MBifolco/jarvis-pcb/jarvis/jarvis.kicad_pcb

## KiCad design jarvis/jarvis.kicad_pcb (2025-08-11)

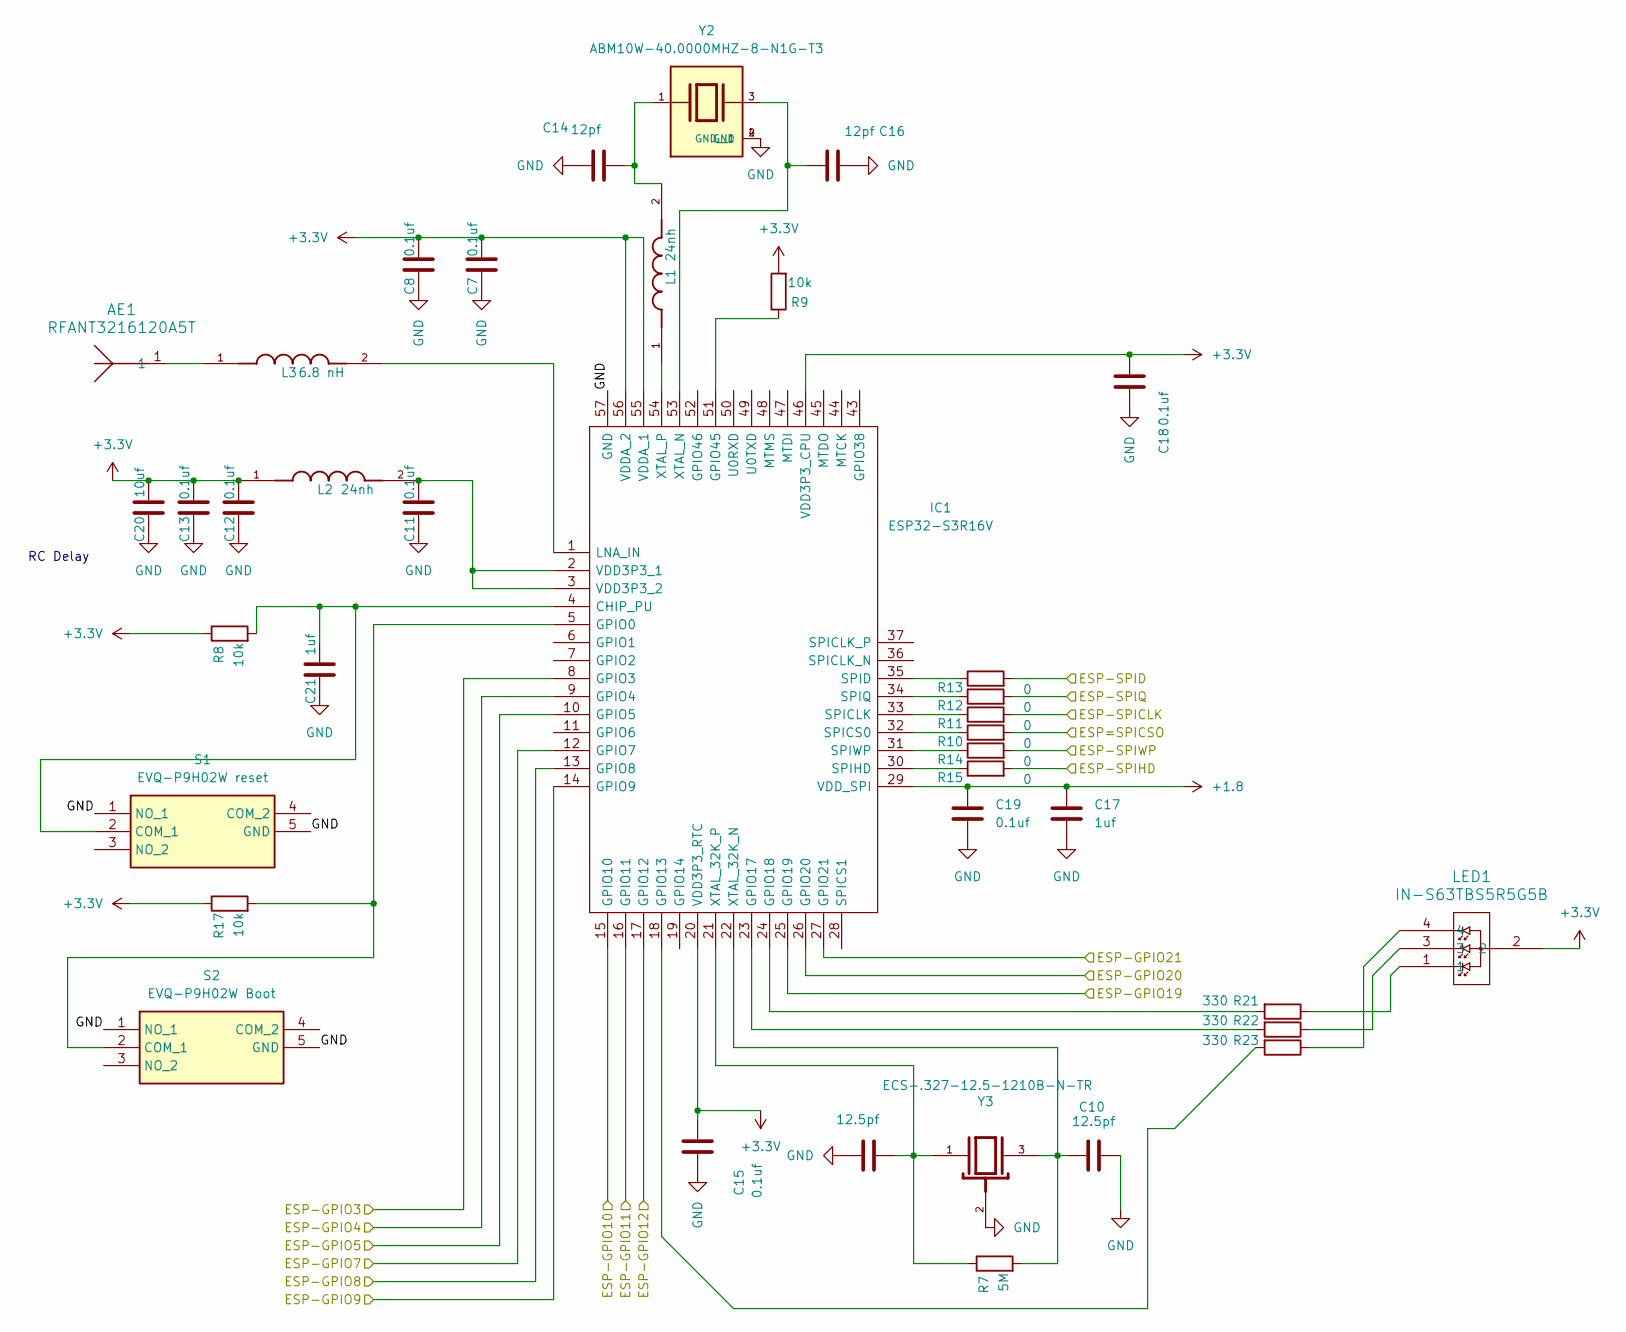
[picture p1: schematic esp.kicad_sch]

Parts:
AE1: RFANT3216120A5T; ANT_RFANT3216120A5T_WAL
C7, C8, C11, C12, C13, C15, C19: 0.1uf; C_0603_1608Metric
C9, C10: 12.5pf; C_0402_1005Metric
C14, C16: 12pf; C_0402_1005Metric
C17, C21: 1uf; C_0603_1608Metric
C18: 0.1uf; C_0402_1005Metric
C20: 10uf; C_0603_1608Metric
IC1: ESP32-S3R16V; esp32-s3r16v; Manufacturer_Part_Number ESP32-S3R16V; Mouser Part Number 356-ESP32-S3R16V
L1, L2: 24nh; MLG1005SR24JT000
L3: 6.8 nH; MLG1005SR24JT000
LED1: IN-S63TBS5R5G5B; IN-S63TBS5R5G5B_INO
R7: 5M; R_0603_1608Metric
R8, R9, R17: 10k; R_0603_1608Metric
R10, R11, R12, R13, R14, R15: 0; R_0603_1608Metric
R21, R22, R23: 330; R_0603_1608Metric
S1: EVQ-P9H02W reset; EVQP9H02W; Manufacturer_Part_Number EVQ-P9H02W; Mouser Part Number 667-EVQ-P9H02W
S2: EVQ-P9H02W Boot; EVQP9H02W; Manufacturer_Part_Number EVQ-P9H02W; Mouser Part Number 667-EVQ-P9H02W
Y2: ABM10W-40.0000MHZ-8-N1G-T3; XTAL_ABM10W-40.0000MHZ-8-N1G-T3; PARTREV 10.06.2020
Y3: ECS-.327-12.5-1210B-N-TR; XTAL_ECS-.327-12.5-1210B-N-TR

Connections:
+1.8: C17.2, C19.2, IC1.29 (VDD_SPI); also elsewhere on the board
+3.3V: C7.1, C8.1, C12.1, C13.1, C15.1, C18.1, C20.1, IC1.20 (VDD3P3_RTC), IC1.46 (VDD3P3_CPU), IC1.55 (VDDA_1), IC1.56 (VDDA_2), L2.1, LED1.2, R8.1, R9.2, R17.1; also elsewhere on the board
/Components/AMP-BCLK: IC1.9 (GPIO4); also elsewhere on the board
/Components/AMP-DIN: IC1.8 (GPIO3); also elsewhere on the board
/Components/AMP-LRCLK: IC1.10 (GPIO5); also elsewhere on the board
/Components/FLASH-CLK: R11.2; also elsewhere on the board
/Components/FLASH-CS: R10.2; also elsewhere on the board
/Components/FLASH-DI_IO0: R13.2; also elsewhere on the board
/Components/FLASH-DO_IO1: R12.2; also elsewhere on the board
/Components/FLASH-HOLD: R15.2; also elsewhere on the board
/Components/FLASH-WP_IO2: R14.2; also elsewhere on the board
/Components/MIC-BCK: IC1.12 (GPIO7); also elsewhere on the board
/Components/MIC-DATA: IC1.14 (GPIO9); also elsewhere on the board
/Components/MIC-WS: IC1.13 (GPIO8); also elsewhere on the board
/ESP/ESP-GPIO10: IC1.15 (GPIO10); also elsewhere on the board
/ESP/ESP-GPIO11: IC1.16 (GPIO11); also elsewhere on the board
/ESP/ESP-GPIO12: IC1.17 (GPIO12); also elsewhere on the board
/ESP/ESP-GPIO19: IC1.25 (GPIO19); also elsewhere on the board
/ESP/ESP-GPIO20: IC1.26 (GPIO20); also elsewhere on the board
/ESP/ESP-GPIO21: IC1.27 (GPIO21)
GND: C7.2, C8.2, C9.2, C10.2, C11.2, C12.2, C13.2, C14.1, C15.2, C16.2, C17.1, C18.2, C19.1, C20.2, C21.2, IC1.57 (GND), S1.1 (NO_1), S1.5 (GND), S2.1 (NO_1), S2.5 (GND), Y2.2 (GND), Y2.4 (GND__1), Y3.2; also elsewhere on the board
unnamed: AE1.1, L3.1
unnamed: C14.2, L1.2, Y2.1
unnamed: C21.1, IC1.4 (CHIP_PU), R8.2, S1.2 (COM_1)
unnamed: IC1.5 (GPIO0), R17.2, S2.2 (COM_1)
unnamed: IC1.18 (GPIO13), R23.2
unnamed: IC1.23 (GPIO17), R22.2
unnamed: IC1.24 (GPIO18), R21.2
unnamed: IC1.51 (GPIO45), R9.1
unnamed: IC1.1 (LNA_IN), L3.2
unnamed: IC1.33 (SPICLK), R11.1
unnamed: IC1.32 (SPICS0), R10.1
unnamed: IC1.35 (SPID), R13.1
unnamed: IC1.30 (SPIHD), R15.1
unnamed: IC1.34 (SPIQ), R12.1
unnamed: IC1.31 (SPIWP), R14.1
unnamed: C11.1, IC1.2 (VDD3P3_1), IC1.3 (VDD3P3_2), L2.2
unnamed: C10.1, IC1.22 (XTAL_32K_N), R7.2, Y3.3
unnamed: C9.1, IC1.21 (XTAL_32K_P), R7.1, Y3.1
unnamed: C16.1, IC1.53 (XTAL_N), Y2.3
unnamed: IC1.54 (XTAL_P), L1.1
unnamed: LED1.1, R21.1
unnamed: LED1.3, R22.1
unnamed: LED1.4, R23.1

Notes on the sheet:
RC Delay

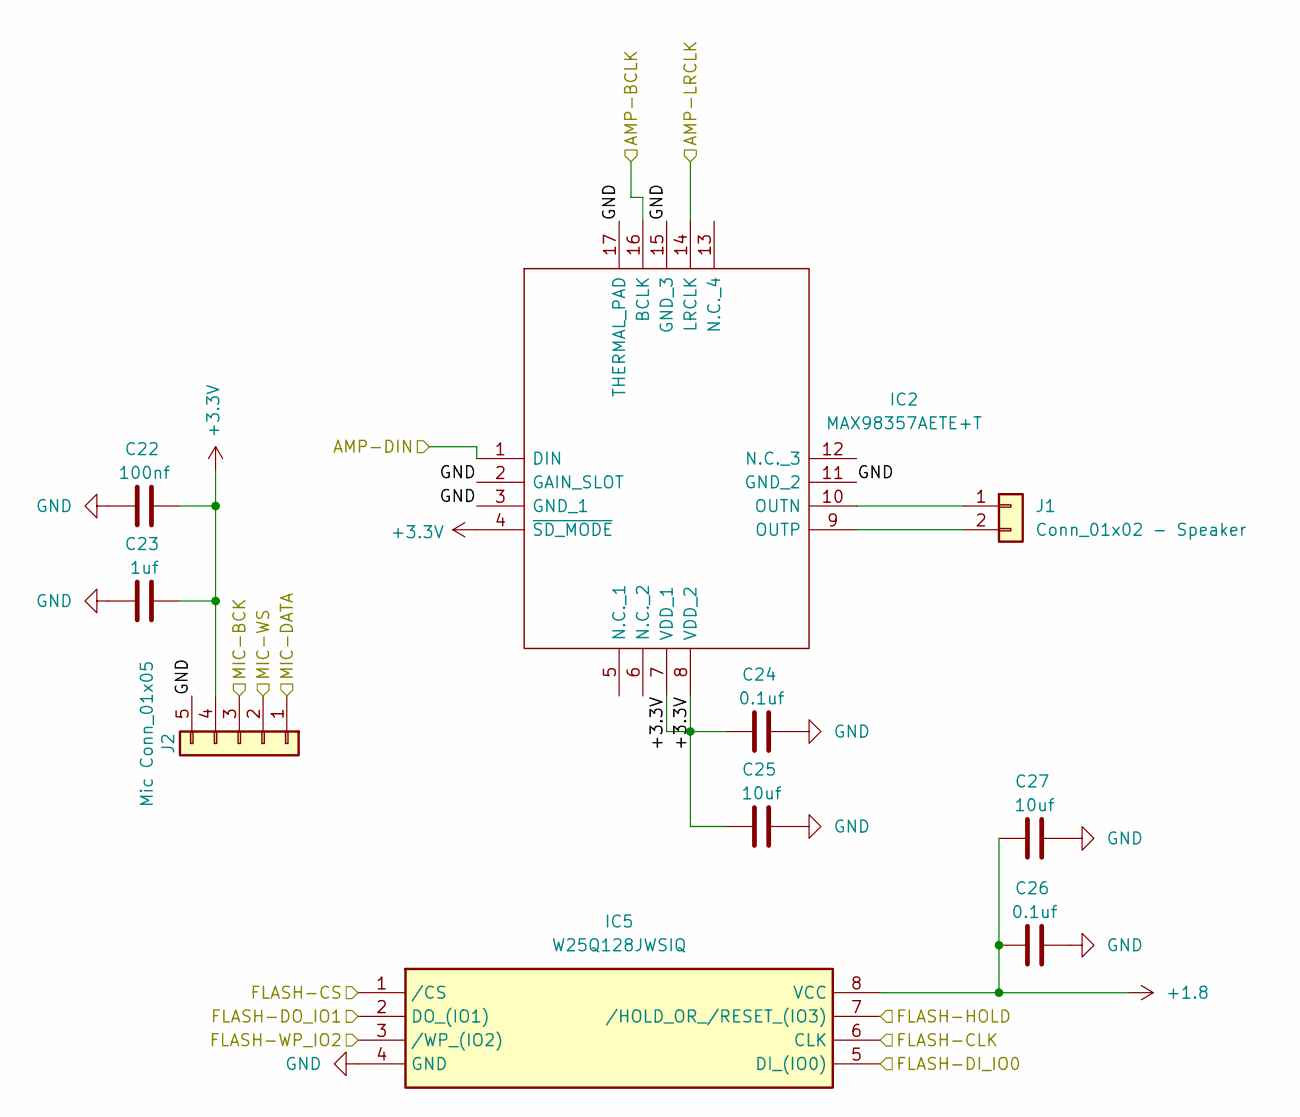
[picture p2: schematic components.kicad_sch]

Parts:
C22: 100nf; C_0603_1608Metric
C23: 1uf; C_0603_1608Metric
C24, C26: 0.1uf; C_0603_1608Metric
C25, C27: 10uf; C_0603_1608Metric
IC2: MAX98357AETE+T; LIB_MAX98357AETE+T; Manufacturer_Part_Number MAX98357AETE+T; Mouser Part Number 700-MAX98357AETE+T
IC5: W25Q128JWSIQ; W25Q128JWSIQ-1.8; Manufacturer_Part_Number W25Q128JWSIQ; Mouser Part Number 454-W25Q128JWSIQ
J1: Conn_01x02 - Speaker; Molex_PicoBlade_53047-0210_1x02_P1.25mm_Vertical
J2: Mic Conn_01x05; Molex_PicoBlade_53047-0510_1x05_P1.25mm_Vertical

Connections:
+1.8: C26.2, C27.2, IC5.8 (VCC); also elsewhere on the board
+3.3V: C22.1, C23.1, C24.2, C25.2, IC2.4 (~SD_MODE), IC2.7 (VDD_1), IC2.8 (VDD_2), J2.4; also elsewhere on the board
/Components/AMP-BCLK: IC2.16 (BCLK); also elsewhere on the board
/Components/AMP-DIN: IC2.1 (DIN); also elsewhere on the board
/Components/AMP-LRCLK: IC2.14 (LRCLK); also elsewhere on the board
/Components/FLASH-CLK: IC5.6 (CLK); also elsewhere on the board
/Components/FLASH-CS: IC5.1 (/CS); also elsewhere on the board
/Components/FLASH-DI_IO0: IC5.5 (DI_(IO0)); also elsewhere on the board
/Components/FLASH-DO_IO1: IC5.2 (DO_(IO1)); also elsewhere on the board
/Components/FLASH-HOLD: IC5.7 (/HOLD_OR_/RESET_(IO3)); also elsewhere on the board
/Components/FLASH-WP_IO2: IC5.3 (/WP_(IO2)); also elsewhere on the board
/Components/MIC-BCK: J2.3; also elsewhere on the board
/Components/MIC-DATA: J2.1; also elsewhere on the board
/Components/MIC-WS: J2.2; also elsewhere on the board
GND: C22.2, C23.2, C24.1, C25.1, C26.1, C27.1, IC2.2 (GAIN_SLOT), IC2.3 (GND_1), IC2.11 (GND_2), IC2.15 (GND_3), IC2.17 (THERMAL_PAD), IC5.4 (GND), J2.5; also elsewhere on the board
unnamed: IC2.10 (OUTN), J1.1
unnamed: IC2.9 (OUTP), J1.2

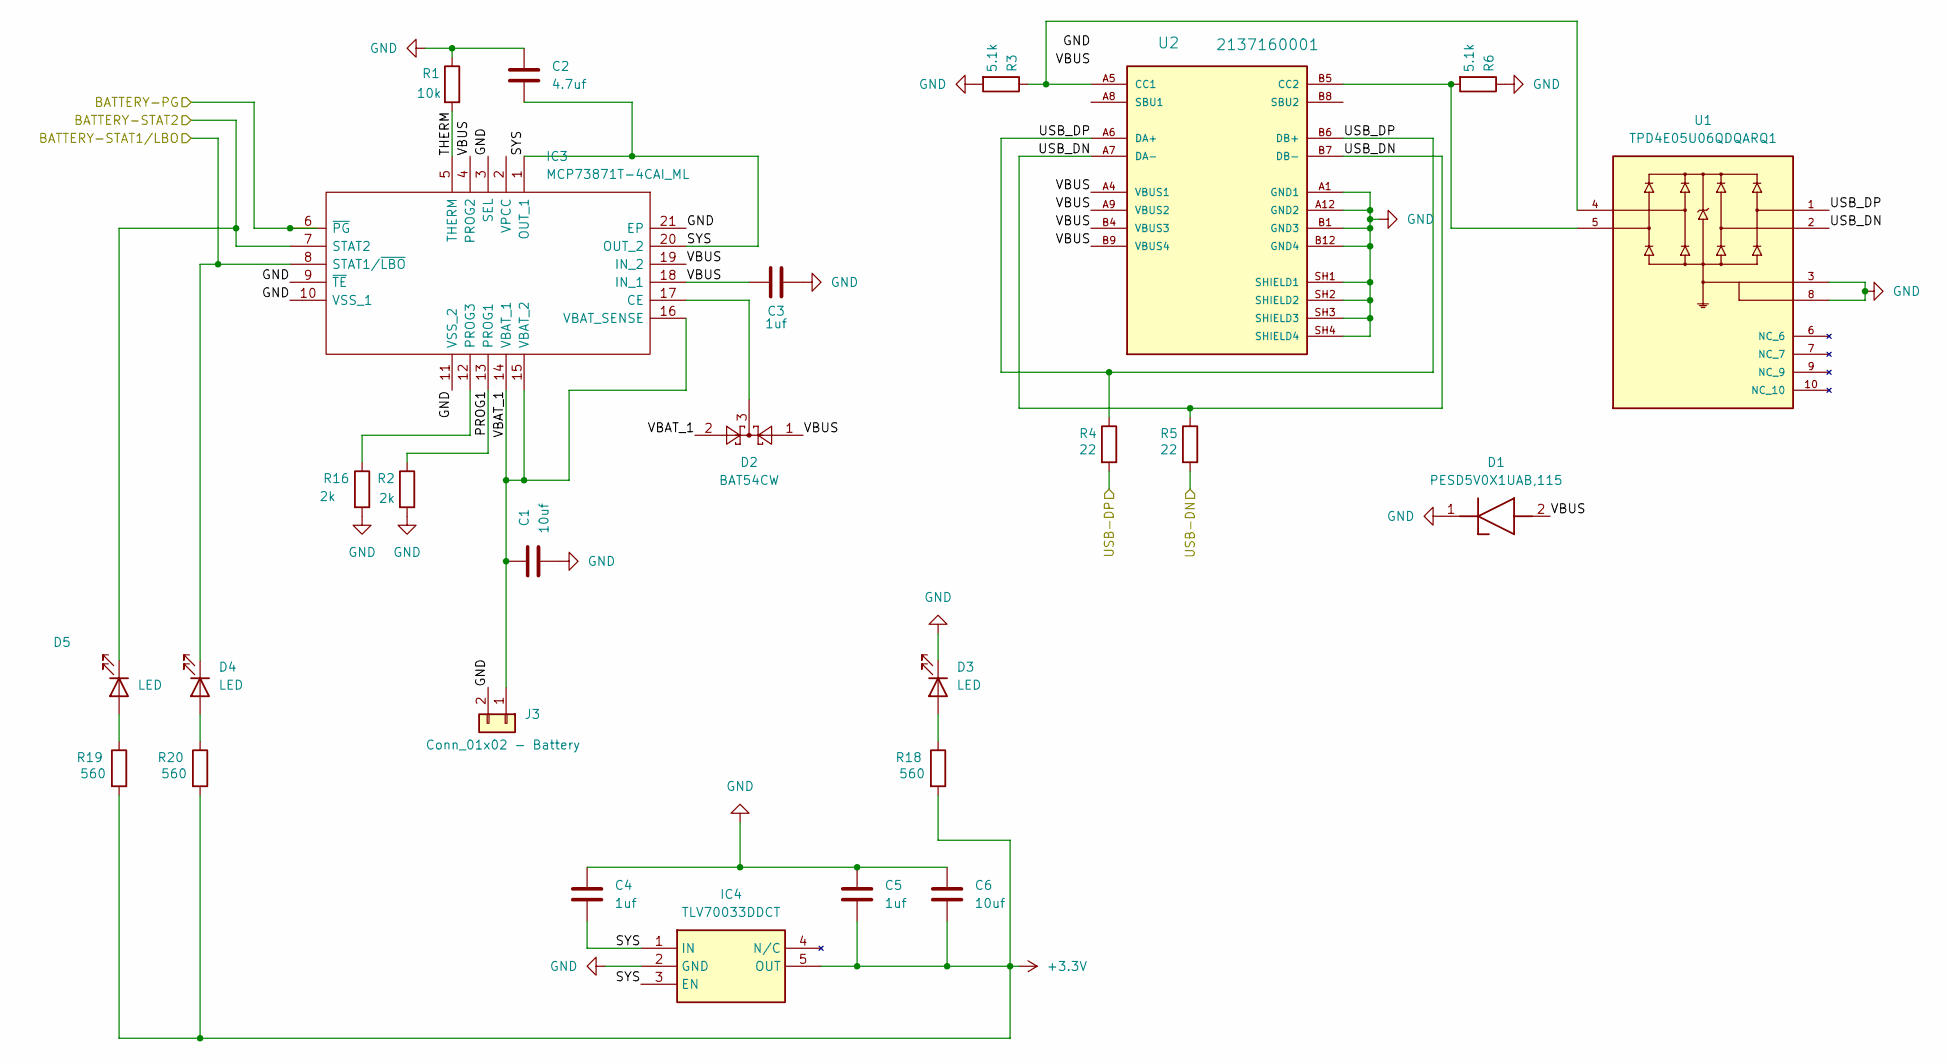
[picture p3: schematic untitled.kicad_sch]

Parts:
C1, C6: 10uf; C_0603_1608Metric
C2: 4.7uf; C_0603_1608Metric
C3, C4, C5: 1uf; C_0603_1608Metric
D1: PESD5V0X1UAB,115; PESD5V0X1UAB115; Manufacturer_Part_Number PESD5V0X1UAB,115; Mouser Part Number 771-PESD5V0X1UAB115
D2: BAT54CW; SOT-323_SC-70_Handsoldering
D3, D4, D5: LED; LED_0603_1608Metric
IC3: MCP73871T-4CAI_ML; MCP73871T-4CAI ML; Manufacturer_Part_Number MCP73871T-4CAI/ML; Mouser Part Number 579-MCP73871T4CAIML
IC4: TLV70033DDCT; Manufacturer_Part_Number TLV70033DDCT; Mouser Part Number 595-TLV70033DDCT
J3: Conn_01x02 - Battery; Molex_PicoBlade_53047-0210_1x02_P1.25mm_Vertical
R1: 10k; R_0603_1608Metric
R2, R16: 2k; R_0603_1608Metric
R3, R6: 5.1k; R_0603_1608Metric
R4, R5: 22; R_0603_1608Metric
R18, R19, R20: 560; R_0603_1608Metric
U1: TPD4E05U06QDQARQ1; IC_TPD4E05U06QDQARQ1; PARTREV F
U2: 2137160001; MOLEX_2137160001-holes; PARTREV B

Connections:
+3.3V: C5.2, C6.2, IC4.5 (OUT), R18.2, R19.2, R20.2; also elsewhere on the board
/ESP/ESP-GPIO10: D4.1 (K), IC3.8 (STAT1/~LBO); also elsewhere on the board
/ESP/ESP-GPIO11: D5.1 (K), IC3.7 (STAT2); also elsewhere on the board
/ESP/ESP-GPIO12: IC3.6 (~PG); also elsewhere on the board
/ESP/ESP-GPIO19: R4.2; also elsewhere on the board
/ESP/ESP-GPIO20: R5.2; also elsewhere on the board
/Power/PROG1: IC3.13 (PROG1), R2.1
/Power/SYS: C2.2, C4.2, IC3.1 (OUT_1), IC3.20 (OUT_2), IC4.1 (IN), IC4.3 (EN)
/Power/THERM: IC3.5 (THERM), R1.2
/Power/VBAT_1: C1.1, D2.2, IC3.14 (VBAT_1), IC3.15 (VBAT_2), IC3.16 (VBAT_SENSE), J3.1
/Power/VBUS: C3.1, D1.2 (A), D2.1, IC3.4 (PROG2), IC3.18 (IN_1), IC3.19 (IN_2), U2.A4 (VBUS1), U2.A9 (VBUS2), U2.B4 (VBUS3), U2.B9 (VBUS4)
GND: C1.2, C2.1, C3.2, C4.1, C5.1, C6.1, D1.1 (K), D3.1 (K), IC3.3 (SEL), IC3.9 (~TE), IC3.10 (VSS_1), IC3.11 (VSS_2), IC3.21 (EP), IC4.2 (GND), J3.2, R1.1, R2.2, R3.2, R6.1, R16.2, U1.3, U1.8, U2.A1 (GND1), U2.A12 (GND2), U2.B1 (GND3), U2.B12 (GND4), U2.SH1 (SHIELD1), U2.SH2 (SHIELD2), U2.SH3 (SHIELD3), U2.SH4 (SHIELD4); also elsewhere on the board
unnamed: D3.2 (A), R18.1
unnamed: D4.2 (A), R20.1
unnamed: D5.2 (A), R19.1
unnamed: D2.3, IC3.17 (CE)
unnamed: IC3.12 (PROG3), R16.1
unnamed: R3.1, U1.4, U2.A5 (CC1)
unnamed: R6.2, U1.5, U2.B5 (CC2)

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
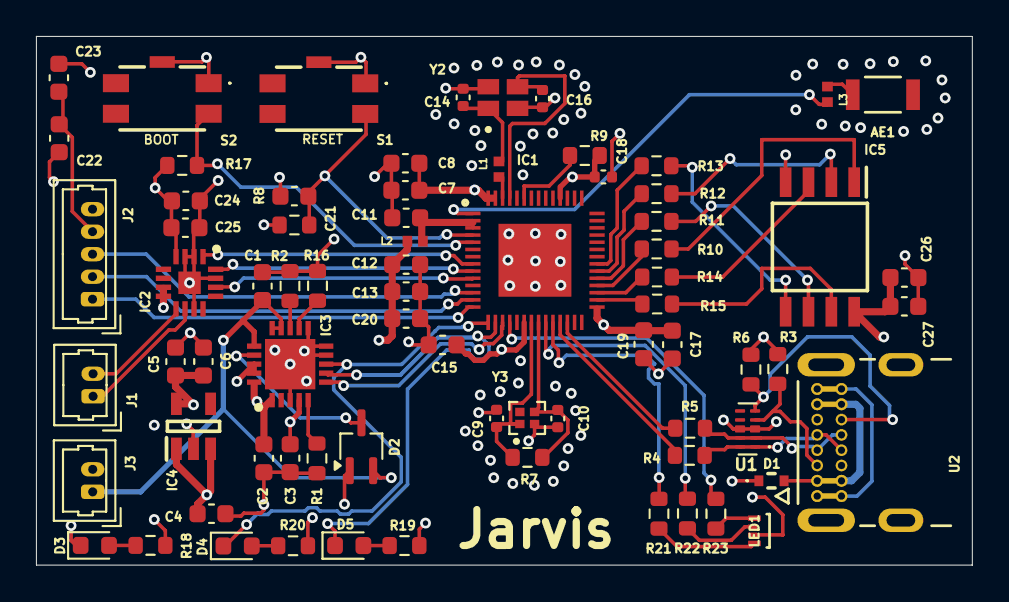
[picture p4: board jarvis.kicad_pcb from above]

Board: 4 copper layers, 52.0 x 29.4 mm, 74 parts (0 on the bottom side), 59 nets.
