MBifolco/jarvis-pcb/jarvis/jarvis_small.kicad_pcb

## KiCad design jarvis/jarvis_small.kicad_pcb (2025-06-12)

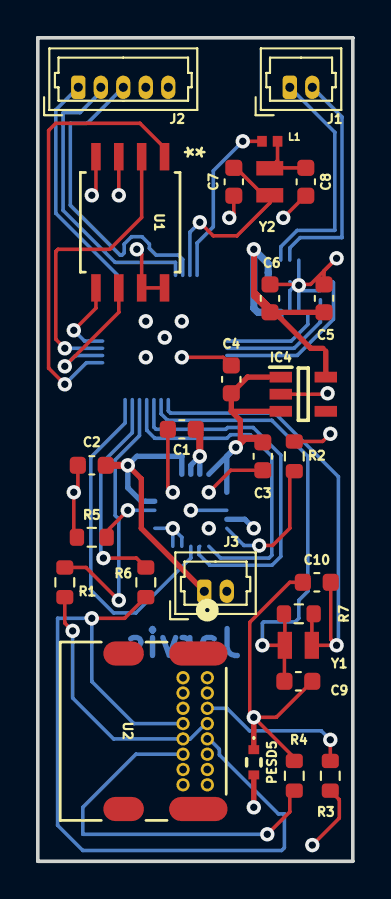
[picture p5: board jarvis_small.kicad_pcb from above]

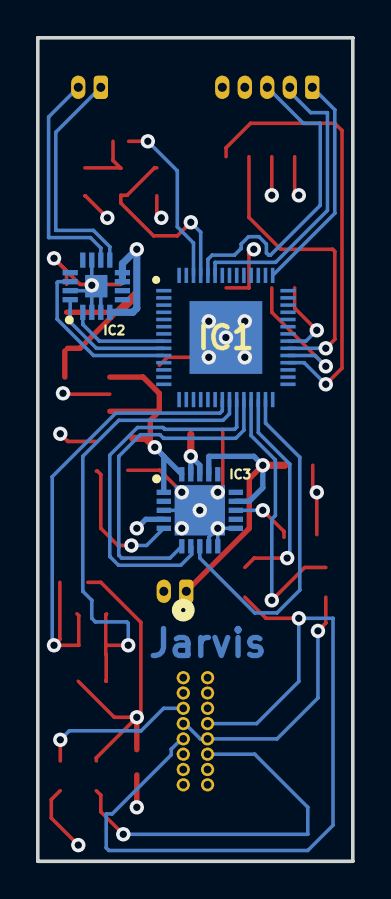
[picture p6: board jarvis_small.kicad_pcb from below]

Board: 4 copper layers, 17.5 x 45.8 mm, 30 parts (3 on the bottom side), 32 nets.

Parts:
C1, C4, C5: 1uf; C_0603_1608Metric
C2, C6: 10uf; C_0603_1608Metric
C3: 4.7uf; C_0603_1608Metric
C7, C8, C9, C10: 12pf; C_0603_1608Metric
IC1: ESP32-S3R16V; esp32-s3r16v
IC2: MAX98357AETE+T; LIB_MAX98357AETE+T
IC3: MCP73871T-4CAI_ML; MCP73871T-4CAI ML
IC4: TLV70033DDCT
J1: Conn_01x02 - Speaker; Molex_PicoBlade_53047-0210_1x02_P1.25mm_Vertical
J2: Mic Conn_01x05; Molex_PicoBlade_53047-0510_1x05_P1.25mm_Vertical
J3: Conn_01x02 - Battery; Molex_PicoBlade_53047-0210_1x02_P1.25mm_Vertical
L1: 24nh; MLG1005SR24JT000
PESD5: PESD5V0X1UAB,115; PESD5V0X1UAB115
R1: 2k; R_0603_1608Metric
R2: 10k; R_0603_1608Metric
R3, R4: 5.1k; R_0603_1608Metric
R5, R6: 22; R_0603_1608Metric
R7: 5M; R_0603_1608Metric
U1: W25Q64JVSSIQ
U2: 2137160001; 2137160001_MOL
Y1: Crystal 32.768khz; XTAL_CM8V-T1A-32.768KHZ-7PF-20PPM-TA-QC
Y2: Crystal 40mhz; XTAL_CM8V-T1A-32.768KHZ-7PF-20PPM-TA-QC

Connections:
+3.3V: C5.2, C6.2, IC2.4 (~SD_MODE), IC2.7 (VDD_1), IC2.8 (VDD_2), IC4.5 (OUT), J2.4, U1.3 (/WP(IO2)), U1.7 (/HOLD_OR_/RESET(IO3)), U1.8 (VCC)
/PROG1: IC3.13 (PROG1), R1.1
/SYS: C3.2, C4.2, IC1.32 (SPICS0), IC3.1 (OUT_1), IC3.20 (OUT_2), IC4.1 (IN), IC4.3 (EN), U1.1 (/CS)
/THERM: IC3.5 (THERM), R2.2
/USB_DN: R6.1, U2.A7 (DN1), U2.B7 (DN2)
/USB_DP: R5.1, U2.A6 (DP1), U2.B6 (DP2)
/VBAT_1: C2.1, IC3.14 (VBAT_1), IC3.17 (CE), J3.1
GND: C1.2, C2.2, C3.1, C4.1, C5.1, C6.1, C7.2, C8.1, C9.2, C10.2, IC1.57 (GND), IC2.2 (GAIN_SLOT), IC2.3 (GND_1), IC2.11 (GND_2), IC2.15 (GND_3), IC2.17 (THERMAL_PAD), IC3.3 (SEL), IC3.9 (~TE), IC3.10 (VSS_1), IC3.11 (VSS_2), IC3.21 (EP), IC4.2 (GND), J2.5, J3.2, PESD5.1 (K), R1.2, R2.1, R3.2, R4.1, U1.4 (GND), U2.A1 (GND), U2.A12 (GND), U2.B1 (GND), U2.B12 (GND)
unnamed: C8.2, L1.2, Y2.2
unnamed: IC1.8 (GPIO3), IC2.1 (DIN)
unnamed: IC1.9 (GPIO4), IC2.16 (BCLK)
unnamed: IC1.10 (GPIO5), IC2.14 (LRCLK)
unnamed: IC1.23 (GPIO17), IC3.7 (STAT2)
unnamed: IC1.24 (GPIO18), IC3.6 (~PG)
unnamed: IC1.25 (GPIO19), R5.2
unnamed: IC1.26 (GPIO20), R6.2
unnamed: IC1.27 (GPIO21), IC3.8 (STAT1/~LBO)
unnamed: IC1.43 (GPIO38), J2.1
unnamed: IC1.51 (GPIO45), J2.2
unnamed: IC1.52 (GPIO46), J2.3
unnamed: IC1.33 (SPICLK), U1.6 (CLK)
unnamed: IC1.35 (SPID), U1.5 (DI(IO0))
unnamed: IC1.34 (SPIQ), U1.2 (DO(IO1))
unnamed: C9.1, IC1.22 (XTAL_32K_N), R7.2, Y1.2
unnamed: C10.1, IC1.21 (XTAL_32K_P), R7.1, Y1.1
unnamed: C7.1, IC1.53 (XTAL_N), Y2.1
unnamed: IC1.54 (XTAL_P), L1.1
unnamed: IC2.10 (OUTN), J1.2
unnamed: IC2.9 (OUTP), J1.1
unnamed: R3.1, U2.A5 (CC1)
unnamed: R4.2, U2.B5 (CC2)
VBUS: C1.1, IC3.4 (PROG2), IC3.18 (IN_1), IC3.19 (IN_2), PESD5.2 (A), U2.A4 (VBUS), U2.A9 (VBUS), U2.B9 (VBUS)
