MBifolco/jarvis-pcb/(commit log)

2025-06-12 flash routed
    [components.kicad_sch, esp.kicad_sch, jarvis.kicad_pcb, jarvis.kicad_sch, jarvis_small.kicad_pcb, untitled.kicad_sch]
2025-06-13 start crystal layout
    [jarvis.kicad_pcb]
2025-06-15 crystals done
    [components.kicad_sch, esp.kicad_sch, jarvis.kicad_pcb, jarvis.kicad_sch, untitled.kicad_sch]
2025-06-15 initial all connections
    [jarvis.kicad_pcb, jarvis.kicad_sch]
2025-08-04 with leds and boot button
    [components.kicad_sch, esp.kicad_sch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]
2025-08-11 small fixes from testing new pcb swap d lines connected pins on power ic that needed to be changed rbg led to be common anode
    [esp.kicad_sch, jarvis.kicad_pcb, jarvis.kicad_sch]
